o-vitaliy/AlertTimelapseEsp/docs/case/case.stl

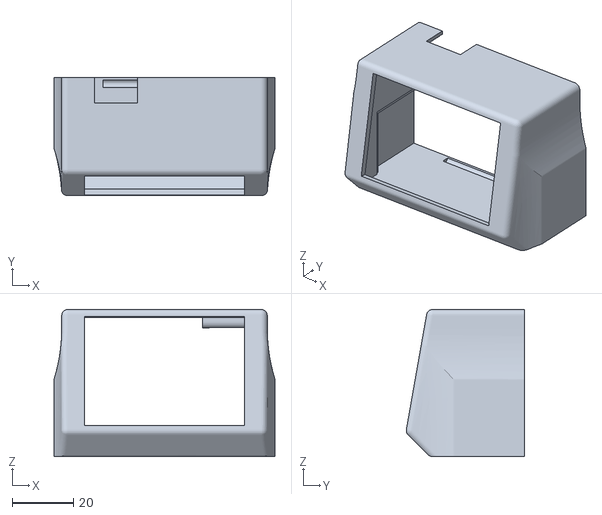
[picture p1: CAD file, 2026-11-08]
docs/case/case.stl
72.0 x 38.6 x 47.9
