o-vitaliy/AlertTimelapseEsp/docs/case/cap.stl

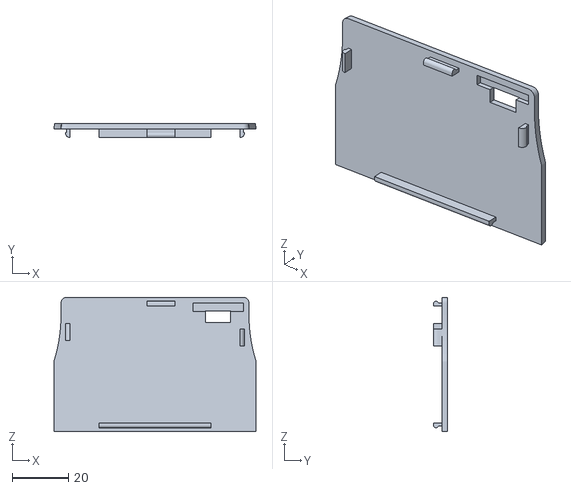
[picture p2: CAD file, 2026-11-08]
docs/case/cap.stl
72.0 x 5.00 x 47.9
