o-vitaliy/AlertTimelapseEsp/include/MapData.h

// Map raster, border palette and place-name tables, generated once from the
// AlertTimelapse geometry. That generator is no longer kept, so this file is
// now maintained as is. The threat icons are in ThreatIcons.h.
//
// The arrays are defined in the one source file that defines
// MAP_DATA_IMPLEMENTATION before including this header, and declared elsewhere.
#pragma once

#include <stdint.h>

namespace map_data {

constexpr int16_t WIDTH = 320;
constexpr int16_t HEIGHT = 240;
constexpr uint16_t HROMADA_COUNT = 1769;
constexpr uint16_t NO_HROMADA = 0xFFFF;

// lon/lat -> screen: x = (lon - LON_MIN) * SCALE + OFFSET_X,
// y = (LAT_MAX - lat) / LAT_SCALE * SCALE + OFFSET_Y.
constexpr float LON_MIN = 22.086912295000115f;
constexpr float LAT_MAX = 52.42929059600003f;
constexpr float LAT_SCALE = 0.6626200482157375f;
constexpr float SCALE = 17.591144958280477f;
constexpr float OFFSET_X = 0.0f;
constexpr float OFFSET_Y = 12.575682954490517f;

// Fill colours (0xRRGGBB) indexed by alert level: none, yellow, red.
constexpr uint32_t LEVEL_RGB[3] = {0x3C4043, 0xFBC02D, 0xE5322D};

// Threat icons (include/ThreatIcons.h) are drawn this many pixels wide, a
// size that depends on the map's scale.
constexpr float ICON_SCREEN_SIZE = 10.554686974968286f;

// Alert place names -> hromadas, as Gazetteer in map_renderer.py resolves them.
// A key is FNV-1a (32-bit) over a kind byte ('O' oblast, 'R' raion,
// 'H' hromada, 'C' city), the normalized oblast name, 0x1F, and the normalized
// place name; an oblast key has the kind and the oblast name only. NAME_KEYS
// holds NAME_KEY_COUNT entries sorted by hash: u32 hash, u16 first index into
// NAME_POOL, u16 count. NAME_POOL holds u16 hromada indexes. All little-endian.
constexpr uint16_t NAME_KEY_COUNT = 3645;
#ifdef MAP_DATA_IMPLEMENTATION
extern const uint8_t NAME_KEYS[29160] = {
  248,73,67,0,0,0,1,0,129,230,82,0,1,0,1,0,21,134,90,0,2,0,1,0,
  197,28,101,0,3,0,1,0,159,50,135,0,4,0,1,0,60,197,153,0,5,0,1,0,
  242,166,156,0,6,0,1,0,140,196,167,0,7,0,1,0,221,122,187,0,8,0,1,0,
  246,112,193,0,9,0,13,0,124,92,206,0,22,0,1,0,56,131,221,0,23,0,7,0,
  250,171,223,0,30,0,1,0,41,195,225,0,31,0,1,0,55,55,245,0,32,0,1,0,
  134,9,250,0,33,0,1,0,165,190,9,1,34,0,1,0,92,229,15,1,35,0,1,0,
  137,117,24,1,36,0,1,0,119,30,25,1,37,0,1,0,154,64,35,1,38,0,1,0,
  224,172,51,1,39,0,1,0,198,49,61,1,40,0,1,0,177,230,62,1,41,0,1,0,
  136,72,64,1,42,0,1,0,249,24,126,1,43,0,1,0,34,133,128,1,44,0,1,0,
  230,15,146,1,45,0,1,0,30,51,162,1,46,0,1,0,213,255,177,1,47,0,1,0,
  235,70,203,1,48,0,1,0,207,107,218,1,49,0,1,0,109,195,219,1,50,0,1,0,
  48,112,244,1,51,0,1,0,0,250,26,2,52,0,64,0,36,60,78,2,116,0,1,0,
  46,104,90,2,117,0,1,0,21,246,98,2,118,0,1,0,203,120,102,2,119,0,1,0,
  106,103,104,2,120,0,1,0,221,255,145,2,121,0,1,0,135,197,154,2,122,0,1,0,
  89,160,161,2,123,0,1,0,134,132,185,2,124,0,1,0,176,76,200,2,125,0,1,0,
  103,159,3,3,126,0,1,0,68,59,34,3,127,0,1,0,220,122,40,3,128,0,1,0,
  76,148,52,3,129,0,1,0,48,122,72,3,130,0,1,0,88,25,81,3,131,0,1,0,
  67,63,143,3,132,0,1,0,115,196,161,3,133,0,1,0,194,157,163,3,134,0,1,0,
  249,246,164,3,135,0,26,0,205,224,165,3,161,0,1,0,184,205,177,3,162,0,1,0,
  17,188,194,3,163,0,1,0,37,157,220,3,164,0,2,0,11,180,237,3,166,0,1,0,
  73,214,238,3,167,0,1,0,96,232,1,4,168,0,1,0,27,84,9,4,169,0,1,0,
  247,228,17,4,170,0,1,0,241,192,22,4,171,0,1,0,104,55,65,4,172,0,1,0,
  163,255,88,4,173,0,1,0,228,189,129,4,174,0,1,0,202,204,137,4,175,0,1,0,
  10,247,210,4,176,0,1,0,235,140,246,4,177,0,1,0,52,151,253,4,178,0,1,0,
  147,254,13,5,179,0,1,0,242,199,20,5,180,0,1,0,27,178,22,5,181,0,1,0,
  24,186,37,5,182,0,1,0,3,52,50,5,183,0,1,0,92,218,73,5,184,0,5,0,
  160,175,87,5,189,0,1,0,196,233,96,5,190,0,1,0,213,66,114,5,191,0,1,0,
  140,58,141,5,192,0,1,0,161,217,142,5,193,0,1,0,57,64,214,5,194,0,1,0,
  202,134,214,5,195,0,3,0,194,188,229,5,198,0,1,0,53,242,16,6,199,0,1,0,
  243,31,31,6,200,0,1,0,10,152,31,6,201,0,1,0,207,126,65,6,202,0,1,0,
  67,43,66,6,203,0,1,0,74,13,69,6,204,0,1,0,183,251,88,6,205,0,1,0,
  62,192,90,6,206,0,1,0,50,155,91,6,207,0,1,0,252,15,97,6,208,0,3,0,
  56,156,111,6,211,0,1,0,188,246,160,6,212,0,1,0,236,36,240,6,213,0,1,0,
  226,194,244,6,214,0,1,0,160,98,8,7,215,0,1,0,26,225,17,7,216,0,9,0,
  66,125,25,7,225,0,1,0,10,160,25,7,226,0,1,0,106,57,28,7,227,0,1,0,
  45,146,73,7,228,0,1,0,150,71,85,7,229,0,1,0,10,72,90,7,230,0,2,0,
  6,160,104,7,232,0,11,0,51,112,145,7,243,0,1,0,232,164,206,7,244,0,1,0,
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
  0,121,90,5,3,0,1,1,0,21,91,5,7,0,1,1,0,21,87,5,3,0,1,99,
  0,123,255,255,1,8,211,1,0,100,0,255,255,1,70,0,159,116,1,1,125,1,54,1,
  70,1,135,0,153,255,255,3,70,1,125,1,97,3,54,1,146,0,162,238,4,0,84,255,
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
};
#else
extern const uint8_t ROWS[71931];
#endif

}  // namespace map_data
