o-vitaliy/AlertTimelapseEsp/include/DisplayConfig.h

#pragma once

#define TFT_CS 10
#define TFT_DC 2
#define TFT_RST 3
#define TFT_SCLK 4
#define TFT_MOSI 5

#define TFT_NATIVE_WIDTH 240
#define TFT_NATIVE_HEIGHT 320
#define TFT_ROTATION 3
#define TFT_INVERT true
