o-vitaliy/AlertTimelapseEsp/(commit log)

2026-11-02 Add ESP32 Wi-Fi setup and display project
2026-11-02 Replace display UI with LVGL demo
    [DisplayConfig.h, main.cpp]
2026-11-03 Switch image refresh to JPEG snapshot endpoint
    Download the image into a heap buffer and close TLS before decoding, and
    reuse one long-lived refresh task. Reduce the LVGL pool to 32 KB so the
    buffer fits in the heap.
    Also add the missing WiFi include, shorten the loop delay to 1 ms, speed
    up builds with a build cache and chain LDF mode, and add CLAUDE.md.
    [ContentPage.cpp, ContentPage.h, main.cpp]
2026-11-03 Add clock and weather overlays to image page
    Draw the time and date in the bottom-left corner and the current
    temperature with a short condition word in the top-right corner.
    - Time and date come from NTP via configTzTime. The time redraws every
    5 seconds from a static strip buffer captured at each image refresh,
    so no background box is drawn.
    - Location comes from ipwho.is once per boot, and weather from
    Open-Meteo every 10 minutes. Both run inside the image refresh task.
    - Adds ArduinoJson for parsing the responses.
    [ContentPage.cpp, ContentPage.h]
2026-11-05 Extract clock and weather into Widget classes
    Add a Widget interface (onShow, fetch, onImageDecoded, draw, tick) and
    move the clock and weather logic and rendering into ClockWidget and
    WeatherWidget. Shared HTTPS helpers live in SecureHttp.
    ContentPage drives its widgets through the interface and keeps the
    image pipeline and page lifecycle.
    Loading sequence: the clock is drawn on the loading screen before the
    image download starts, and the time is erased with black until the first
    image is shown. Weather is fetched after the image. A failed image load
    keeps the "Loading..." label and retries after 10 s instead of showing
    "Image unavailable".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
    [ClockWidget.cpp, ClockWidget.h, ContentPage.cpp, ContentPage.h, SecureHttp.cpp, SecureHttp.h, WeatherWidget.cpp, WeatherWidget.h]
2026-11-06 Add assembly manual and wiring diagram
    Covers parts, power chain (18650, TP4056, switch, boost), display
    wiring from DisplayConfig.h, case layout from case/cap STLs,
    step-by-step assembly, first start and troubleshooting.
2026-11-06 Add case STL files and link them from the manual
    [cap.stl, case.stl]
2026-11-08 Render the alert map on the device
    The screen no longer downloads a JPEG from the AlertTimelapse server. It
    reads alerts from alerts.in.ua and threats from NEPTUN directly, and
    draws the map from data compiled into the firmware.
    - MapData.h, generated by the server repo's device_map.py, holds the map
    as a run-length encoded hromada index per pixel, the place-name hash
    tables and the threat icons.
    - PlaceNames matches alert names to hromadas as the server's Gazetteer
    does; MapRenderer renders rows with rotated threat icons.
    - AlertSources streams both APIs one array element at a time. The
    alerts.in.ua token comes from the ALERTS_API_TOKEN environment variable
    at build time.
    - The m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
    [AlertSources.cpp, AlertSources.h, ClockWidget.cpp, ClockWidget.h, ContentPage.cpp, ContentPage.h, MapData.h, MapRenderer.cpp]
2026-11-08 Keep the threat icons in this repository
    The firmware no longer needs anything from the AlertTimelapse repo.
    - assets/threat_icons holds the 13 icon PNGs.
    - tools/threat_icons.py turns them into include/ThreatIcons.h: 28x28
    RGBA per icon, plus the NEPTUN threat type to icon table. The output
    is byte-identical to the icons previously in MapData.h.
    - MapData.h keeps only the map raster, border palette, name tables and
    the icon draw size. Its generator is no longer kept, which CLAUDE.md
    now says.
    - Comments no longer describe the code in terms of the old server.
    [AlertSources.cpp, ContentPage.cpp, MapData.h, MapRenderer.cpp, PlaceNames.cpp, PlaceNames.h]
2026-11-08 Update case and cap STLs
    The cap's USB-C opening is now T-shaped, with a slot above it for the
    edge of the TP4056 board, and the TP4056 pocket is 1 mm deeper. The
    case's internal ribs and snap features have small adjustments.
    [cap.stl, case.stl]
2026-11-08 Restart on button press, reset Wi-Fi on long press
    The BOOT button on GPIO 9 restarts the device on a short press. Holding
    it for 5 seconds erases the saved Wi-Fi settings and restarts, bringing
    up the setup portal.
    [main.cpp]
2026-11-08 Add README
    Cover what the device shows, hardware and wiring, building with the
    alerts.in.ua token, first setup, the button, configuration, data sources
    and privacy, threat icons and the map data. Link the assembly manual and
    CLAUDE.md for details.
